Mula8641/AutWat-Sys-v2/(list of files, drawings)

Other design files:
AutWaSys_Sim.pdsprj
legacy/AutWaSys_Sim.pdsprj
