Mula8641/AutWat-Sys-v2/docs/hardware_results.md

# Hardware results

Empty until the circuit is built. Do not fill with estimates.

| Measurement | Value | Date | Evidence |
|---|---|---|---|
| Probe raw ADC, dry air | | | |
| Probe raw ADC, in water | | | |
| Measured flow rate (mL/s) | | | |
| Delivered volume, Cactus (300 mL dose) | | | |
| Delivered volume, AloeVera (300 mL dose) | | | |
| Delivered volume, ZamioculcasZamifolia (250 mL dose) | | | |
| Relay active level confirmed | | | |
| Pump does not pulse at power on | | | |
| WiFi: `curl /status` screenshot | | | |
| WiFi: `POST /water` starts pump | | | |
| BLE: status read screenshot | | | |
| BLE: command write screenshot | | | |
| 24 hour run without crash or stuck pump | | | |
