Mula8641/AutWat-Sys-v2/src/net/status_server.h

#pragma once
#include "command.h"
#include "status_json.h"

void statusServerBegin();
void statusServerTick();
void statusServerPublish(const autwat::StatusSnapshot& snapshot);
autwat::Command statusServerTakeCommand();
