Mula8641/AutWat-Sys-v2/(commit log)

2026-10-10 Rebuild as modular ESP32 firmware with unit tested control logic
    [AutWaSys_Sim.pdsprj]
2026-10-10 Add README, wiring doc, environment notes and scripted controller run
2026-10-10 Pad LCD lines and match the Wokwi relay level in the simulator build
2026-10-10 Add Wokwi screenshots and wiring image
